elemental-platform/element-e106/README.md

# element-e106
Wireless temperature, relative humidity and light sensor based on RFM69 radio

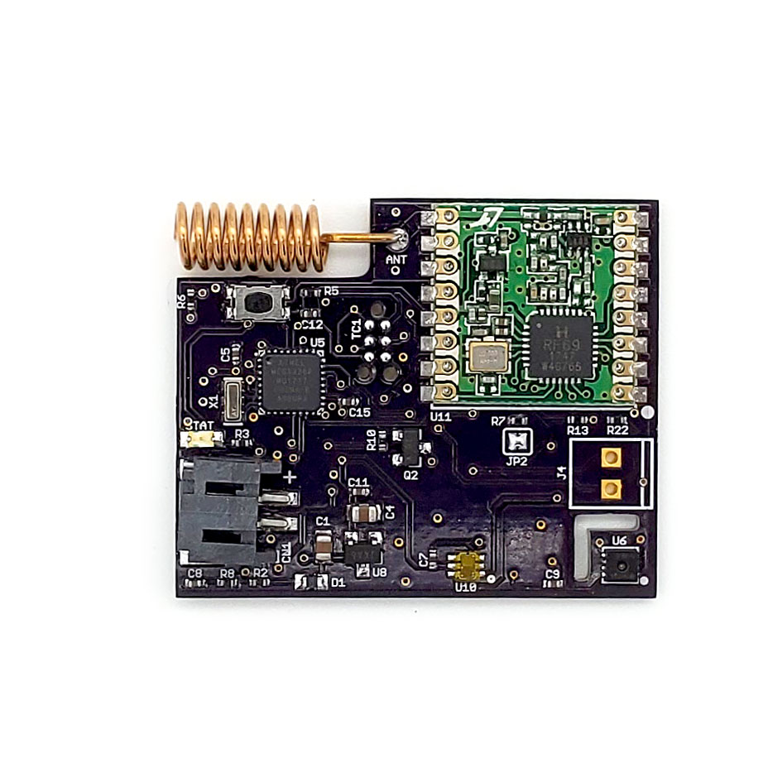
[picture p1: e106.jpg]
element e106
