elemental-platform/element-e106/hardware/E106.brd

## EAGLE design hardware/E106.brd (2019-10-17)

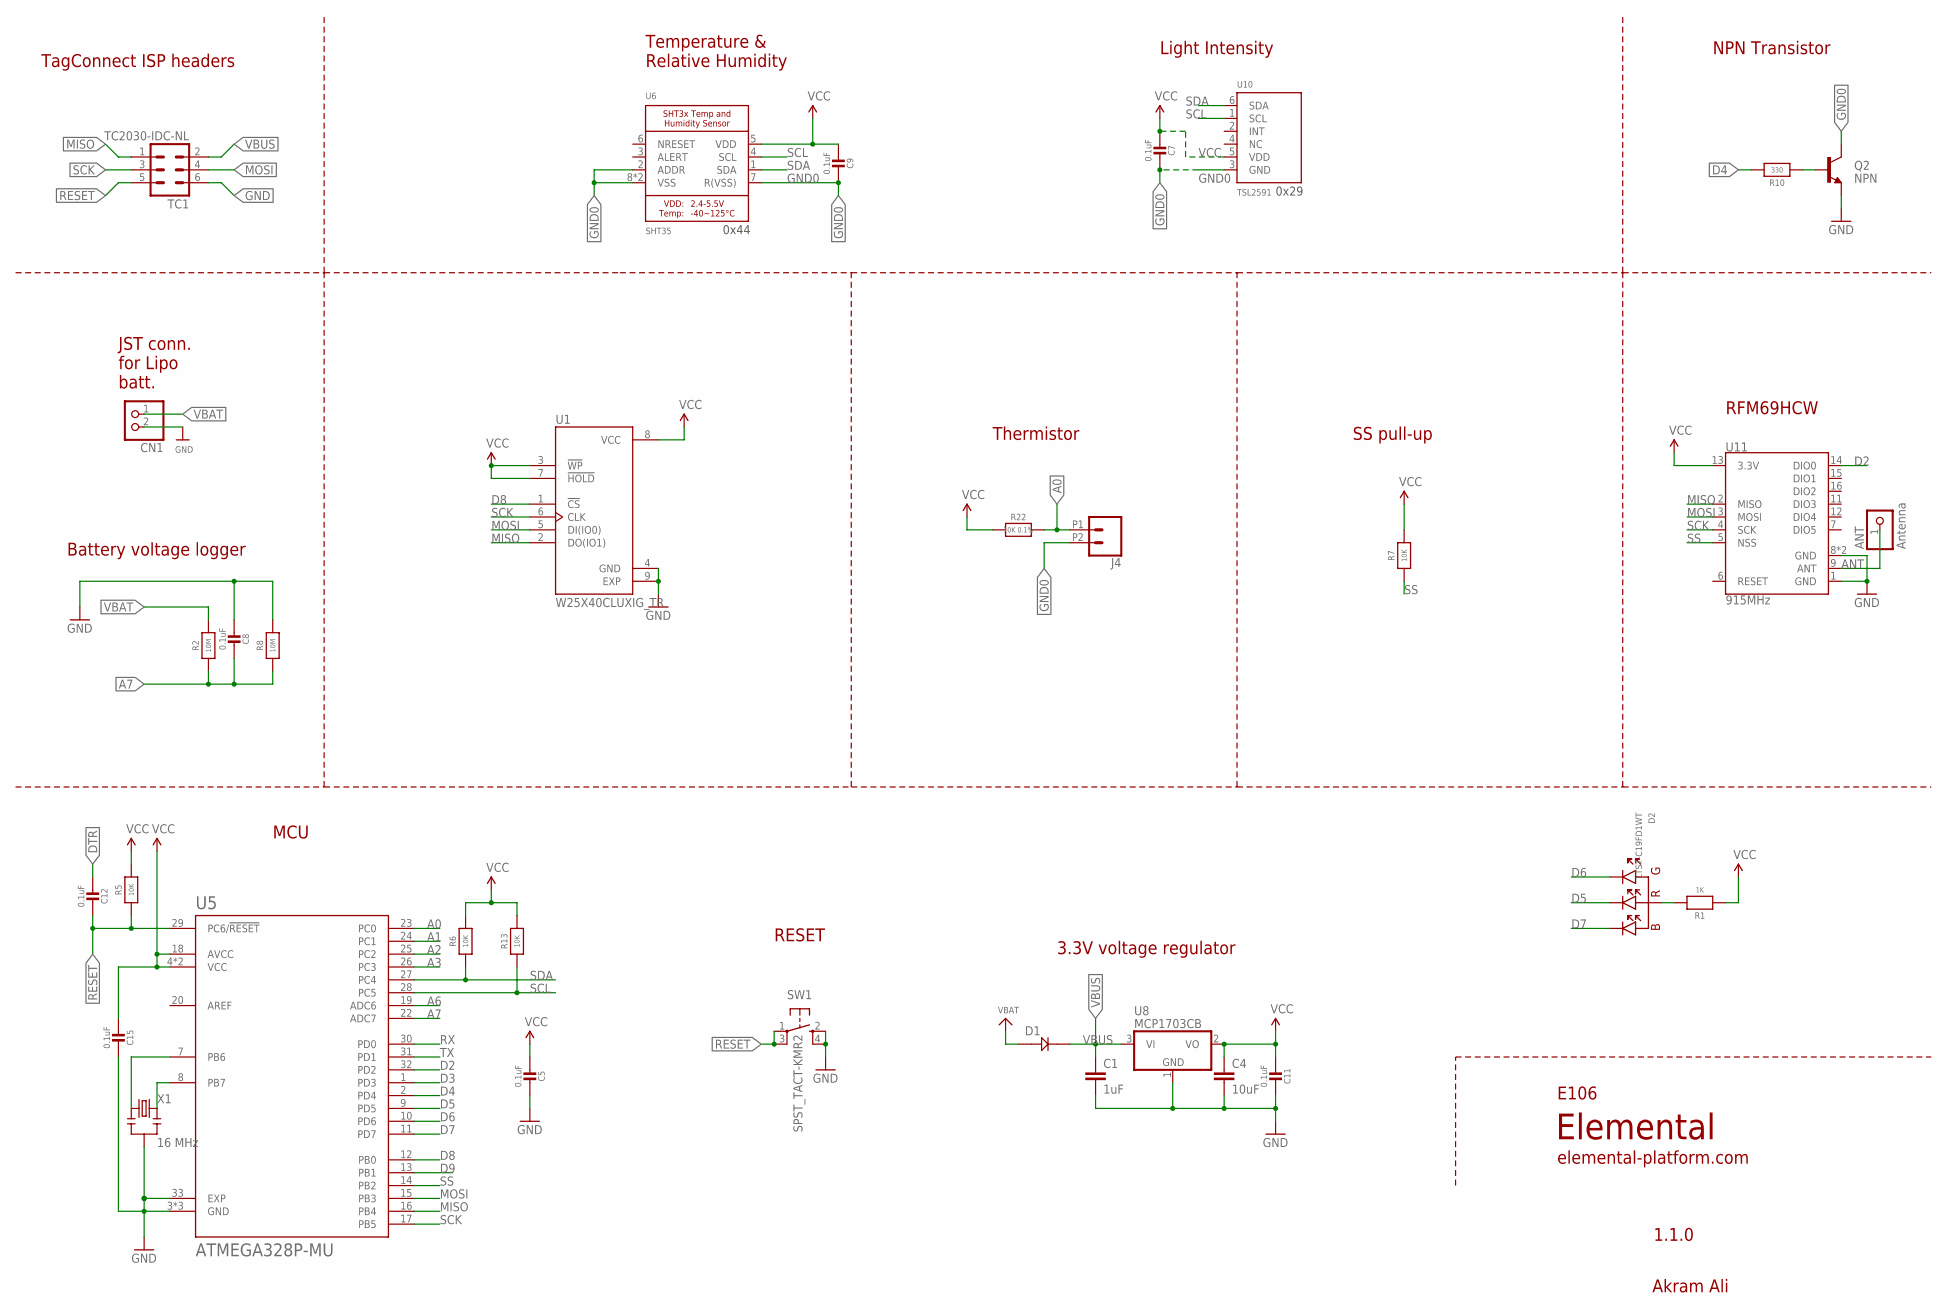
[picture p2: schematic E106.sch]

Parts:
ANT: Antenna; 1X01-CLEANBIG; MPN Helical antenna
C1: 1uF; 0805; MPN CC0805ZRY5V8BB105
C4: 10uF; 0805; MPN CC0805KKX5R6BB106
C5, C7, C8, C9, C11, C12, C15: 0.1uF; MICROBUILDER__0402MP; MPN GRM155R71C104KA88J
CN1: JST_2PIN-SMT-RA; JST-PH-2-SMT-RA
D1: DIODE_SCHOTTKY0805-RES; 0805
D2: LTST-C19FD1WT; 4-SMD
J4: CONN_022.54MM_SCREWTERM; 1X02_2.54_SCREWTERM
Q2: NPN; SOT23-3@1
R1: 1K; MICROBUILDER__0402MP; MPN RC0402JR-0710KL
R2, R8: 10M; MICROBUILDER__0402MP; MPN RC0402JR-0710KL
R5, R6, R7, R13: 10K; MICROBUILDER__0402MP; MPN RC0402JR-0710KL
R10: 330; MICROBUILDER__0402MP; MPN RC0402JR-0710KL
R22: 10K 0.1%; MICROBUILDER__0402MP; MPN RC0402JR-0727RL
SW1: SPST_TACT-KMR2; KMR2
TC1: TC2030-IDC-NL
U1: W25X40CLUXIG_TR; PSON50P300X200X60-9N
U5: ATMEGA328P-MU; QFN50P500X500X100-33N; MPN ATMEGA328P-MU
U6: SHT35; SHT3X; MPN SHT35-DIS-B
U8: MCP1703CB; SOT23; MPN MCP1703T-3302E/CB
U10: TSL2591; DFN6_TAOS; MPN TSL25911FN
U11: 915MHz; RFM69HCW-XXXS2; MPN RFM69HCW
X1: 16 MHz; RESONATOR-SMD; MPN CSTCE16M0V53-R0

Connections:
A0: J4.P1 (1), R22.2, U5.23 (PC0)
A1: U5.24 (PC1)
A2: U5.25 (PC2)
A3: U5.26 (PC3)
A6: U5.19 (ADC6)
A7: C8.1, R2.1, R8.1, U5.22 (ADC7)
ANT: ANT.1, U11.9 (ANT)
D2: U5.32 (PD2), U11.14 (DIO0)
D3: U5.1 (PD3)
D4: R10.2, U5.2 (PD4)
D5: D2.2 (C2), U5.9 (PD5)
D6: D2.3 (C3), U5.10 (PD6)
D7: D2.1 (C1), U5.11 (PD7)
D8: U1.1 (!CS), U5.12 (PB0)
D9: U5.13 (PB1)
DTR: C12.2
GND: C1.2, C4.2, C5.1, C8.2, C11.1, C15.1, CN1.2 (1), Q2.2 (E), R8.2, SW1.2 (S), SW1.4 (S1), TC1.6, U1.4 (GND), U1.9 (EXP), U5.3 (GND), U5.5 (GND), U5.21 (GND), U5.33 (EXP), U8.1 (GND), U11.1 (GND), U11.8 (GND), U11.10 (GND), X1.2
GND0: C7.1, C9.1, J4.P2 (2), Q2.3 (C), U6.2 (ADDR), U6.7 (R(VSS)), U6.8 (VSS), U6.THERMAL (VSS), U10.3 (GND)
MISO: TC1.1, U1.2 (DO(IO1)), U5.16 (PB4), U11.2 (MISO)
MOSI: TC1.4, U1.5 (DI(IO0)), U5.15 (PB3), U11.3 (MOSI)
unnamed: U5.8 (PB7), X1.3
unnamed: U5.7 (PB6), X1.1
unnamed: D2.4 (A), R1.2
unnamed: Q2.1 (B), R10.1
RESET: C12.1, R5.1, SW1.1, SW1.3 (P1), TC1.5, U5.29 (PC6/!RESET)
RX: U5.30 (PD0)
SCK: TC1.3, U1.6 (CLK), U5.17 (PB5), U11.4 (SCK)
SCL: R13.1, U5.28 (PC5), U6.4 (SCL), U10.1 (SCL)
SDA: R6.1, U5.27 (PC4), U6.1 (SDA), U10.6 (SDA)
SS: R7.1, U5.14 (PB2), U11.5 (NSS)
TX: U5.31 (PD1)
VBAT: CN1.1 (2), D1.1, R2.2
VBUS: C1.1, D1.2, TC1.2, U8.3 (VI)
VCC: C4.1, C5.2, C7.2, C9.2, C11.2, C15.2, R1.1, R5.2, R6.2, R7.2, R13.2, R22.1, U1.3 (!WP), U1.7 (!HOLD), U1.8 (VCC), U5.4 (VCC), U5.6 (VCC), U5.18 (AVCC), U6.5 (VDD), U8.2 (VO), U10.5 (VDD), U11.13 (3.3V)

Notes on the sheet:
Temperature & Relative Humidity
TagConnect ISP headers
3.3V voltage regulator
Elemental
E106
Akram Ali
1.1.0
elemental-platform.com
RFM69HCW
MCU
RESET
0x44
Battery voltage logger
NPN Transistor
JST conn. for Lipo batt.
Thermistor
SS pull-up
Light Intensity
0x29

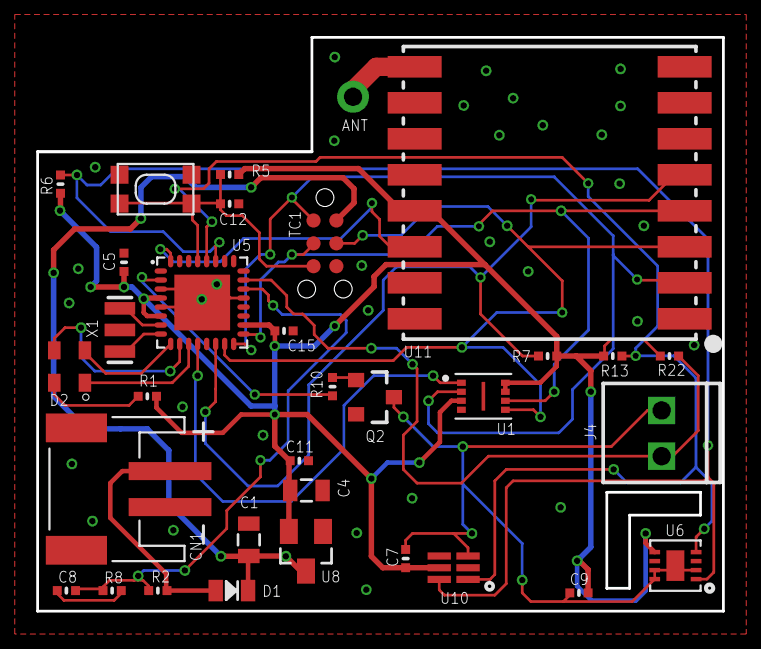
[picture p3: board E106.brd from above]

Board: 2 copper layers, 38.1 x 31.9 mm, 33 parts (0 on the bottom side), 25 nets.
