elemental-platform/element-e106/firmware/firmware.ino

//*****************************************************************************************************************************
// Element E106 v1.1.3 firmware
// Developed by AKstudios

// Updated: 02/04/2020

//*****************************************************************************************************************************
// libraries in use

#include <RFM69.h>  //  https://github.com/LowPowerLab/RFM69
#include <SPI.h>
#include <Wire.h> 
#include <Arduino.h>
#include <avr/wdt.h>
#include <avr/sleep.h>
#include <Adafruit_SHT31.h> //https://github.com/adafruit/Adafruit_SHT31
#include <Adafruit_TSL2591.h> // https://github.com/adafruit/Adafruit_TSL2591_Library
#include <Adafruit_ADS1015.h> // https://github.com/adafruit/Adafruit_ADS1X15

//*****************************************************************************************************************************
// configurable global variables - define node parameters

#define NODEID              21  // supports 10bit addresses (up to 1023 node IDs)
#define NETWORKID           20
#define CONTROLNODE_ID      20
#define GATEWAYID           1
#define GATEWAY_NETWORKID   1
#define FREQUENCY           RF69_915MHZ //Match this with the version of your Moteino! (others: RF69_433MHZ, RF69_868MHZ)
#define ENCRYPTKEY          "RgUjXn2r5u8x/A?D" //has to be same 16 characters/bytes on all nodes, not more not less!
#define FREQUENCY_EXACT     905000000   // change the frequency in areas of interference (default: 915MHz)
#define IS_RFM69HW          //uncomment only for RFM69HW! Leave out if you have RFM69W!
#define LED                 9 // led pin
#define RED                 5
#define GREEN               6
#define BLUE                7
#define POWER               4
#define HAS_CONTROL_NODE    //uncomment only if a control node is present
//#define IS_16BIT          //uncomment only if the board uses a 16-bit ADC. Leave commented out if built-in 10-bit ADC is used.
//#define IS_RGBLED           //uncomment only if RGB LED is used. Otherwise single color LED is used


// other global objects and variables
RFM69 radio;
Adafruit_SHT31 sht31 = Adafruit_SHT31();
Adafruit_TSL2591 tsl = Adafruit_TSL2591(2591); // pass in a number for the sensor identifier (for your use later)
Adafruit_ADS1115 ads;

int wake_interval = 0;
float batt;
char dataPacket[150];
float adc16;

//*****************************************************************************************************************************
// Interrupt service routine for watchdog timer

ISR(WDT_vect)  // Interrupt Service Routine for WatchDog Timer
{
  wdt_disable();  // disable watchdog
}

//*****************************************************************************************************************************

void setup()
{
  //Serial.begin(115200);
  pinMode(POWER, OUTPUT);

  radio.initialize(FREQUENCY,NODEID,GATEWAY_NETWORKID);
  radio.encrypt(ENCRYPTKEY);
#ifdef IS_RFM69HW
  radio.setHighPower(); //uncomment only for RFM69HW!
#endif
#ifdef FREQUENCY_EXACT
  radio.setFrequency(FREQUENCY_EXACT); //set frequency to some custom frequency
#endif
  
#ifdef IS_RGBLED
  pinMode(RED, OUTPUT);
  pinMode(GREEN, OUTPUT);
  pinMode(BLUE, OUTPUT);
  digitalWrite(RED, HIGH);  // important - define LED pin states
  digitalWrite(GREEN, HIGH);
  digitalWrite(BLUE, HIGH);
  fadeRGBLED(GREEN);
#else
  pinMode(LED, OUTPUT);  // pin 9 controls LED
  fadeLED(LED);
#endif  
}

//*****************************************************************************************************************************
// this function puts the node to sleep

void sleep()
{
  Serial.flush(); // empty the send buffer, before continue with; going to sleep
  radio.sleep();
  digitalWrite(POWER, LOW);
  delayMicroseconds(100);

  cli();          // stop interrupts
  MCUSR = 0;
  WDTCSR  = (1<<WDCE | 1<<WDE);     // watchdog change enable
  WDTCSR  = 1<<WDIE | (1<<WDP3) | (0<<WDP2) | (0<<WDP1) | (1<<WDP0); // set  prescaler to 8 second
  sei();  // enable global interrupts
 
  byte _ADCSRA = ADCSRA;  // save ADC state
  ADCSRA &= ~(1 << ADEN);

  asm("wdr");
  set_sleep_mode(SLEEP_MODE_PWR_DOWN);
  cli();       

  sleep_enable();  
  sleep_bod_disable();
  sei();       
  sleep_cpu();   
    
  sleep_disable();   
  sei();  

  ADCSRA = _ADCSRA; // restore ADC state (enable ADC)
//  delayMicroseconds(10);
}

//*****************************************************************************************************************************

void loop() 
{
  sleep();
  
  if(wake_interval == 4)    // if enough time has passed (5 intervals = ~54 seconds), take measurements and transmit
  {
    readSensors();
    
    // send datapacket
    radio.send(GATEWAYID, dataPacket, strlen(dataPacket));
#ifdef HAS_CONTROL_NODE
    sleep();   // sleep 8 seconds before sending data to control node
    radio.setNetwork(NETWORKID);
    radio.sendWithRetry(CONTROLNODE_ID, dataPacket, strlen(dataPacket));  // send data
    radio.setNetwork(GATEWAY_NETWORKID);
#endif

#ifdef IS_RGBLED
    blinkRGBLED(GREEN, 3);
    checkBattery();
#else
    blinkLED(LED, 3);
#endif

    memset(dataPacket, 0, sizeof dataPacket);   // clear array
    wake_interval = 0;    // reset wake interval to 0
  }
  else
    wake_interval++;    // increment no. of times node wakes up
}

//*****************************************************************************************************************************
// This function reads all sensors and creates a datapacket to transmit

void readSensors()
{
  digitalWrite(POWER, HIGH);
  delayMicroseconds(200);

  // Light Intensity - TSL2591
  float lux, infrared;
  tsl.begin();
  tsl.setGain(TSL2591_GAIN_MED);      // 25x gain
  tsl.setTiming(TSL2591_INTEGRATIONTIME_100MS);  // shortest integration time (bright light)
  sensors_event_t event;
  tsl.getEvent(&event);
  if ((event.light == 0) | (event.light > 4294966000.0) | (event.light <-4294966000.0))
  {
    lux = 0;  // invalid value; replace with 'NAN' if needed
  }
  else
  {
    lux = event.light;
    if (lux > 90000)
      lux = 90000; // cap the maximum value at 90K lux
  }
  
  // T/RH - SHT31
  sht31.begin(0x44);
  float temp = sht31.readTemperature();
  float rh = sht31.readHumidity();

  // external temp reading
#ifdef IS_16BIT   // ADS1115 16-bit ADC -- external air temperature
  ads.begin();
  ads.setGain(GAIN_ONE);
  delay(1);
  adc16 = samples16bit(1, 5);   // get ADC value from channel 1, average of 5 samples
  float R = resistance(adc16, 10000); // Replace 10,000 ohm with the actual resistance of the resistor measured using a multimeter (e.g. 9880 ohm)
  float air_temp = steinhart_2(R);  // get temperature from thermistor using the custom Steinhart-hart equation by US sensors

#else   // 10-bit internal ADC reading
  float adc = samples10bit(A0, 5); // get ADC value from pin A0, average of 5 samples
  float R = resistance(adc, 10000); // Replace 10,000 ohm with the actual resistance of the resistor measured using a multimeter (e.g. 9880 ohm)
  float air_temp = steinhart_2(R);  // get temperature from thermistor using the custom Steinhart-hart equation
  if (air_temp < -200 || air_temp > 1000) // thermistor not connected or incorrect value
    air_temp = 0;
#endif

  // read battery level
  float avg=0.0;
  for(int i=0; i<5; i++)
  {
    avg = avg + analogRead(A7);
  }
  float adc_a7 = avg / 5.0;
  batt = (adc_a7/1023) * 2 * 3.3;

  // define character arrays for all variables
  //char _i[3];
  char _t[7];
  char _h[7];
  char _l[7];
  char _a[7];
  char _b[5];

  // convert all flaoting point and integer variables into character arrays
  //dtostrf(NODEID, 1, 0, _i);
  dtostrf(temp, 3, 2, _t);  // this function converts float into char array. 3 is minimum width, 2 is decimal precision
  dtostrf(rh, 3, 2, _h);
  dtostrf(lux, 1, 0, _l);
  dtostrf(air_temp, 3, 2, _a);
  dtostrf(batt, 4, 2, _b);
  
  dataPacket[0] = 0;  // first value of dataPacket should be a 0
  
  // create datapacket by combining all character arrays into a large character array
  //strcat(dataPacket, "i:");
  //strcat(dataPacket, _i);
  strcat(dataPacket, "t:");
  strcat(dataPacket, _t);
  strcat(dataPacket, ",h:");
  strcat(dataPacket, _h);
  strcat(dataPacket, ",l:");
  strcat(dataPacket, _l);
  strcat(dataPacket, ",a:");
  strcat(dataPacket, _a);
  strcat(dataPacket, ",b:");
  strcat(dataPacket, _b);
  delay(1);
}

//*****************************************************************************************************************************
// This function takes samples from the analog pins on ADS1115 16-bit ADC
// It performs multiple iterations to get higher accuracy ADC values (reduce noise)

float samples16bit(int pin, int n)
{
//  float n=5.0;  // number of iterations to perform
  float sum=0.0;  //store sum as a 32-bit number
  for(int i=0;i<n;i++)
  {
    float value = ads.readADC_SingleEnded(pin);
    sum = sum + value;
    delayMicroseconds(10); // makes readings slower - probably don't need this delay, but ¯\_(ツ)_/¯
  }
  float average = sum/float(n);   //store average as a 32-bit number with decimal accuracy
  return average;
}

//*****************************************************************************************************************************
// This function takes samples from the 10-bit analog pins on the Arduino
// It performs multiple iterations to get higher accuracy ADC values (reduce noise)

float samples10bit(int pin, int n)
{
  // float n=5.0;
  float sum=0.0;
  for(int i=0;i<n;i++)
  {
     sum = sum + analogRead(pin);
     delayMicroseconds(10); // makes readings slower - probably don't need this delay, but ¯\_(ツ)_/¯
  }
  float average = sum/float(n);
  return average;
}

//*****************************************************************************************************************************
// This function converts the ADC values to a resistance value

float resistance(float adc, int true_R)
{
  
#ifdef IS_16BIT
  float ADCvalue = adc*(8.192/3.3);  // Vcc = 8.192 on GAIN_ONE setting, Arduino Vcc = 3.3V in this case
  float R = true_R/(65535/ADCvalue-1);  // 65535 refers to 16-bit number
#else
  float R = true_R/(1023.0/adc-1.0);   // convert 10-bit reading into resistance
#endif

  return R;
}

//*****************************************************************************************************************************
// This function converts the resistance value to a temperature value
// Based on the Steinhart equation (Adafruit's 10K Precision Epoxy Thermistor - 3950 NTC) *****************

float steinhart_2(float R)
{
  float steinhart;
  steinhart = R / 10000;     // (R/Ro)
  steinhart = log(steinhart);                  // ln(R/Ro)
  steinhart /= 3950.0;                   // 1/B * ln(R/Ro)
  steinhart += 1.0 / (25.0 + 273.15); // + (1/To)
  steinhart = 1.0 / steinhart;                 // Invert
  steinhart -= 273.15;                         // convert to C

  return steinhart;
}

//*****************************************************************************************************************************
// This function checks the battery level and blinks an LED if the level is low

void checkBattery()
{
  if(batt < 3.65)
    fadeRGBLED(RED);
}

//*****************************************************************************************************************************
// Fade LED

void fadeLED(int pin)
{
  int brightness = 0;
  int fadeAmount = 5;
  for(int i=0; i<510; i=i+5)  // 255 is max analog value, 255 * 2 = 510
  {
    analogWrite(pin, brightness);  // pin 9 is LED
  
    // change the brightness for next time through the loop:
    brightness = brightness + fadeAmount;  // increment brightness level by 5 each time (0 is lowest, 255 is highest)
  
    // reverse the direction of the fading at the ends of the fade:
    if (brightness <= 0 || brightness >= 255)
    {
      fadeAmount = -fadeAmount;
    }
    // wait for 20-30 milliseconds to see the dimming effect
    delay(10);
  }
  digitalWrite(pin, LOW); // switch LED off at the end of fade
}

//*****************************************************************************************************************************
// blink LED

void blinkLED(int pin, int blinkDelay)
{
  digitalWrite(pin, HIGH);
  delay(blinkDelay);
  digitalWrite(pin, LOW);
}

//*****************************************************************************************************************************
// Fade RGB LED (common anode)

void fadeRGBLED(int pin)
{
  int brightness = 255;
  int fadeAmount = 5;
  for(int i=0; i<510; i=i+5)  // 255 is max analog value, 255 * 2 = 510
  {
    analogWrite(pin, brightness);
  
    // change the brightness for next time through the loop:
    brightness = brightness - fadeAmount;  // increment brightness level by 5 each time (0 is lowest, 255 is highest)
  
    // reverse the direction of the fading at the ends of the fade:
    if (brightness <= 0 || brightness >= 255)
    {
      fadeAmount = -fadeAmount;
    }
    // wait for 20-30 milliseconds to see the dimming effect
    delay(10);
  }
  digitalWrite(pin, HIGH); // switch LED off at the end of fade
}

//*****************************************************************************************************************************
// blink RGB LED (common anode)

void blinkRGBLED(int pin, int blinkDelay)
{
  digitalWrite(pin, LOW);
  delay(blinkDelay);
  digitalWrite(pin, HIGH);
}

//*****************************************************************************************************************************
// bruh
