elemental-platform/element-e106/(commit log)

2019-10-09 v1.1.0 - hardware update
    - added SPI flash
    - removed jumper from radio SS
    - added RGB LED instead of single LED
    - trace fixes
    - ERC/DRC
    - Silkscreen update
    [E106.brd, E106.sch]
2019-10-17 minor adjustments
    [E106.brd, E106.sch]
2019-10-17 added silkscreen for node id
    [E106.brd]
2019-12-23 Update firmware.ino
    added pin outputs
2020-01-23 v1.1.0
    - cleaned up code a lot
    - rearranged everything so it's much better ocntrolled now
    - can control RGB led and 16-bit with just one line now
    - added various ifdefs to control everything else, so no need to change everything except node parameters
2020-01-23 added upper limit to lux levels
    - just in case the value is too high, cap it at 90K
    [firmware.ino]
2020-01-23 minor bug fixes
    - fixed global variables to be in scope
    - reduced delays
    - rearranged code a bit more
    - compile check
    [firmware.ino]
2020-01-23 Update firmware.ino
    changed gateway packet to only send once without asking for acknowledgement so the "air" is clear and the node doesn't attemp sending multiple packets all the time
    [firmware.ino]
